westonb/open-pmic-pcb/testing/eff_test1.csv

Vin | Iin | Pin | Vout | Iout | Pout
3.3000000000000003 | 0.0032875000000000005 | 0.010848750000000002 | 1.7969175000000002 | 0.0 | 0.0
3.3000000000000003 | 0.008387499999999999 | 0.02767875 | 1.796665 | 0.00959778 | 0.0172439954037
3.3001250000000004 | 0.013874999999999998 | 0.045789234375 | 1.7965787500000001 | 0.0195675125 | 0.03515457714785938
3.3000000000000003 | 0.01945 | 0.064185 | 1.7963137500000002 | 0.02970505 | 0.053359589759437505
3.3000000000000003 | 0.02495 | 0.082335 | 1.79613 | 0.0395469375 | 0.07103144085187499
3.3000000000000003 | 0.0307625 | 0.10151625000000002 | 1.7960725 | 0.049707387500000005 | 0.08927807173559375
3.3000000000000003 | 0.036399999999999995 | 0.12011999999999999 | 1.7958449999999997 | 0.0596313 | 0.10708857194849998
3.3000000000000003 | 0.042074999999999994 | 0.13884749999999998 | 1.7958175 | 0.06977268750000001 | 0.12529901323453127
3.3000000000000003 | 0.047725 | 0.1574925 | 1.7956525 | 0.079599375 | 0.1429328167171875
3.3000000000000003 | 0.0534625 | 0.17642625000000003 | 1.795515 | 0.08966632499999999 | 0.16099723153237497
3.3000000000000003 | 0.05945 | 0.19618500000000003 | 1.79535 | 0.09971620000000002 | 0.17902547967000004
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
