westonb/open-pmic-pcb/testing/current_sense_50ma.PNG

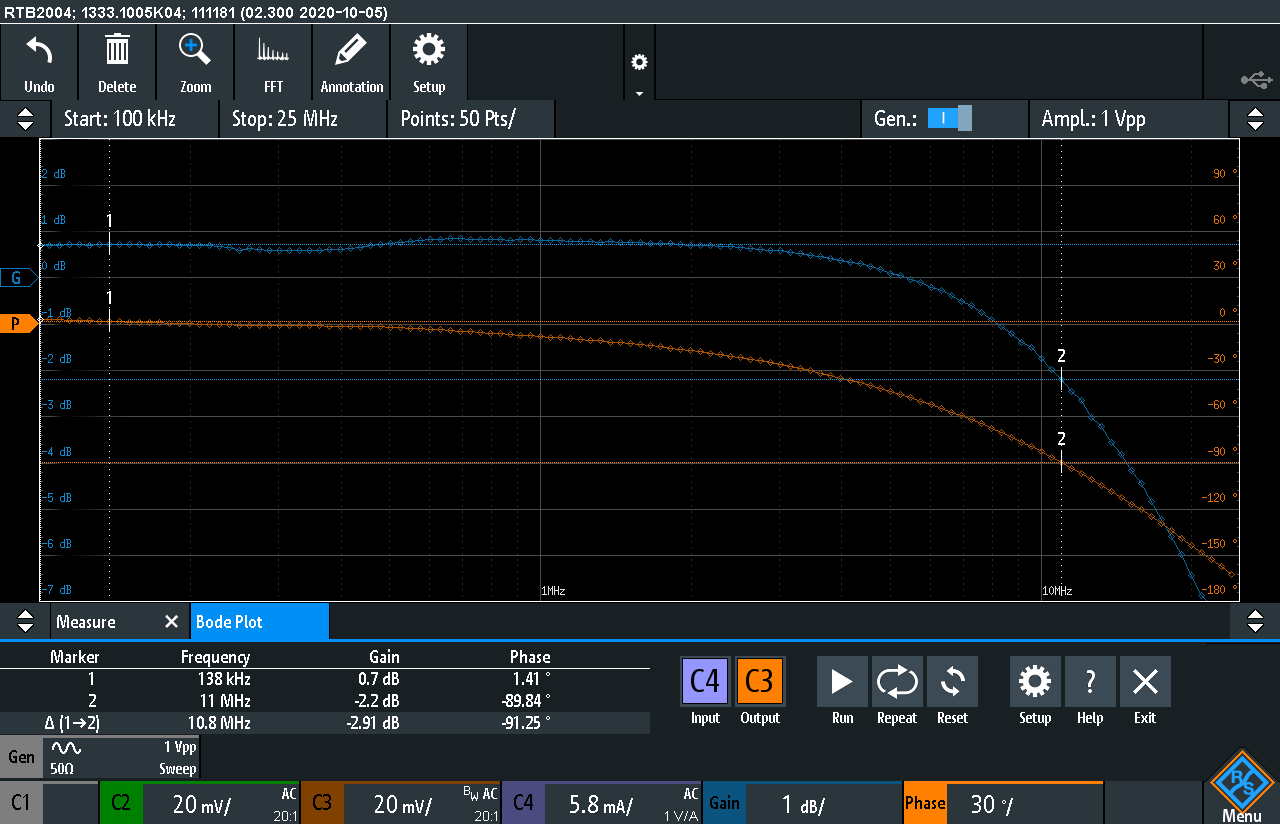
testing/current_sense_50ma.PNG
