westonb/open-pmic-pcb/testing/current_sense_200ma.PNG

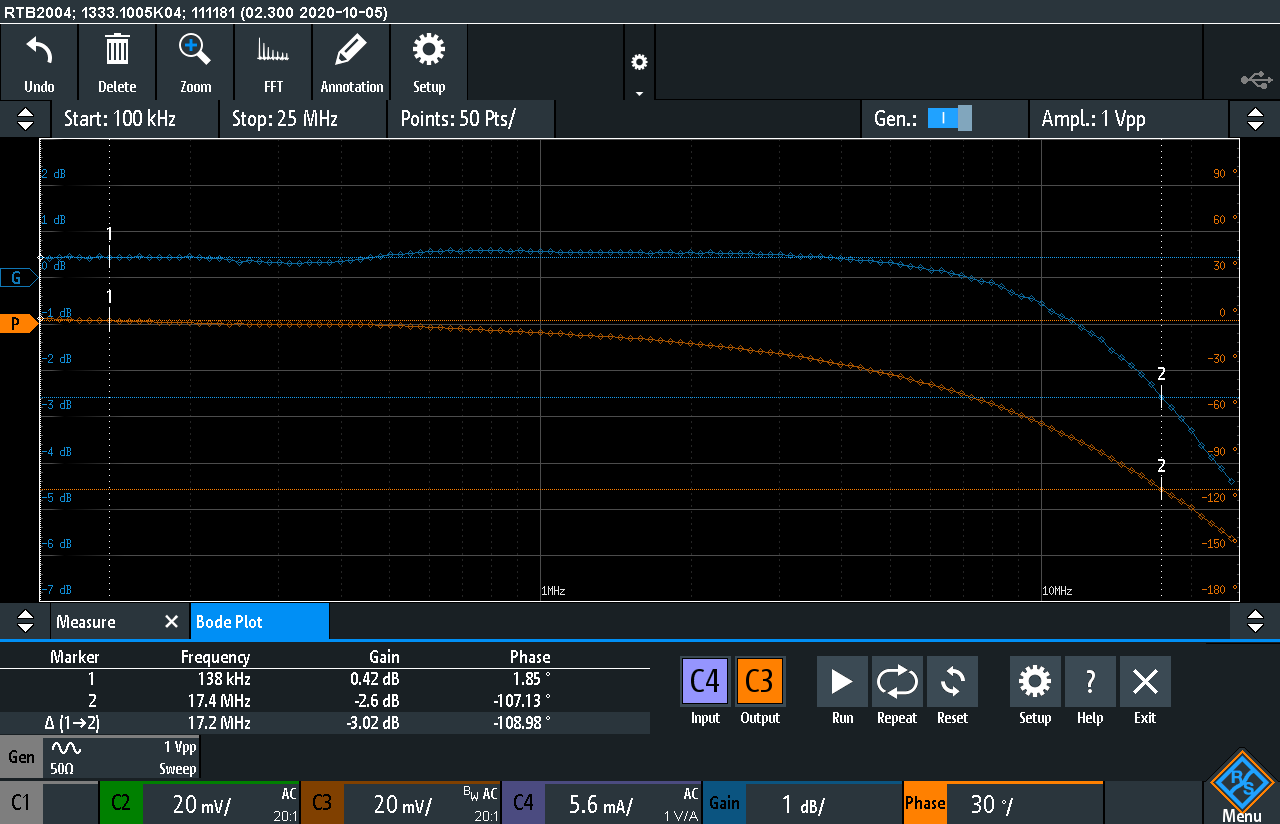
testing/current_sense_200ma.PNG
