westonb/open-pmic-pcb/testing/eff1.png

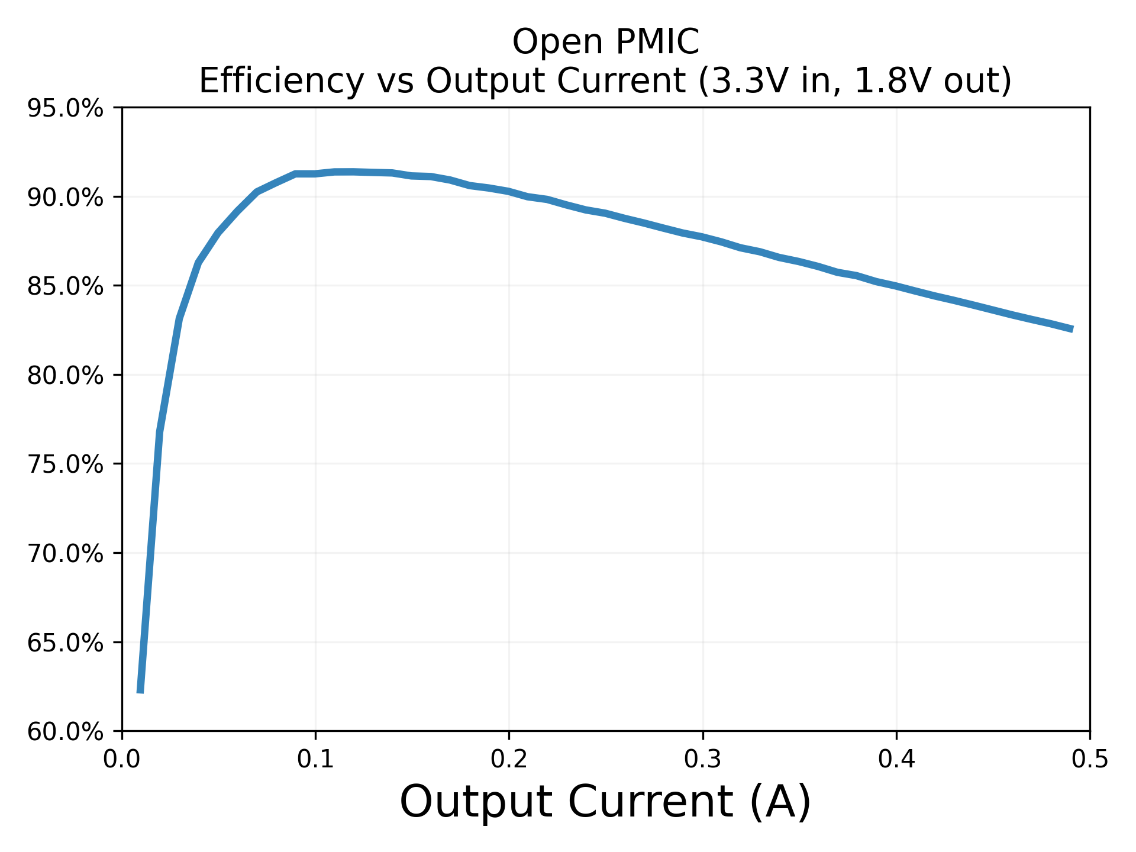
testing/eff1.png
