westonb/open-pmic-pcb/testing/loop_gain_6_ohm.PNG

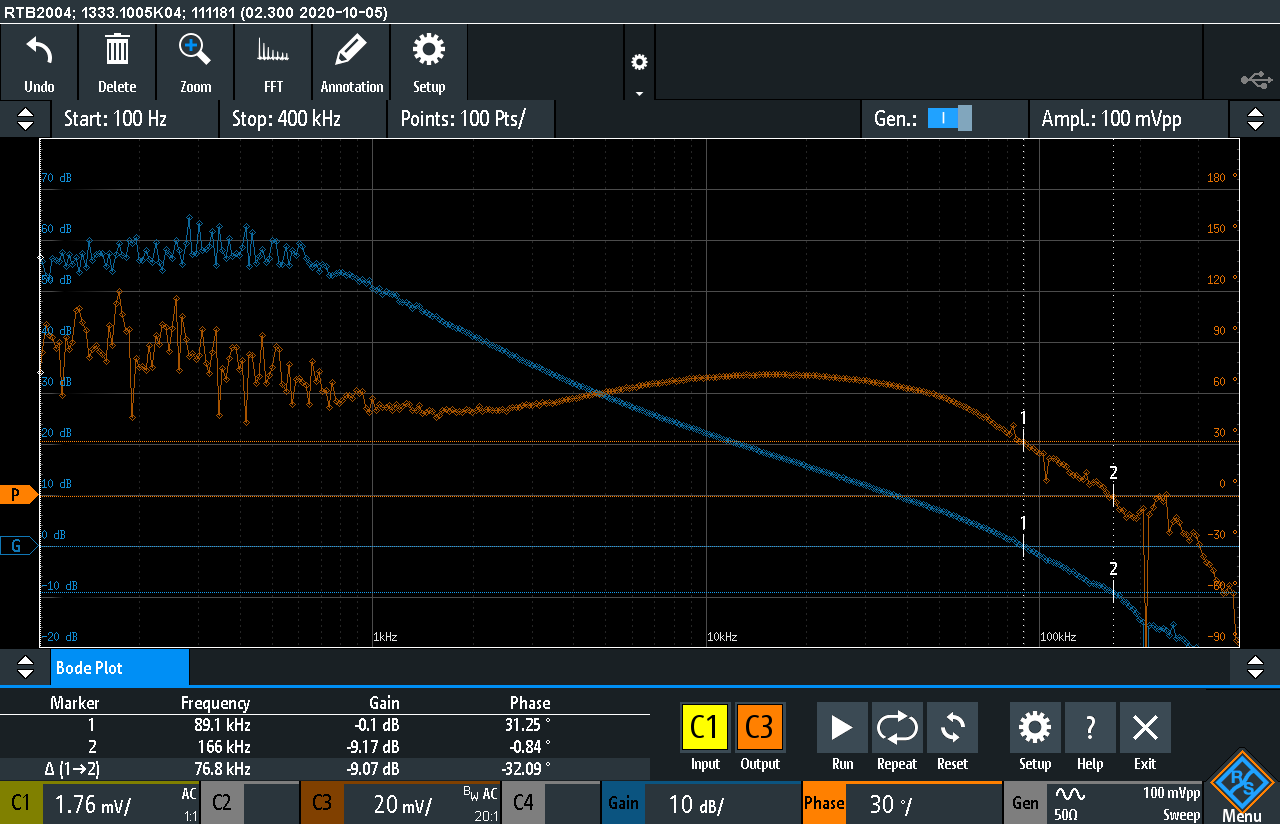
testing/loop_gain_6_ohm.PNG
