westonb/open-pmic-pcb/testing/loop_gain_12_ohm.PNG

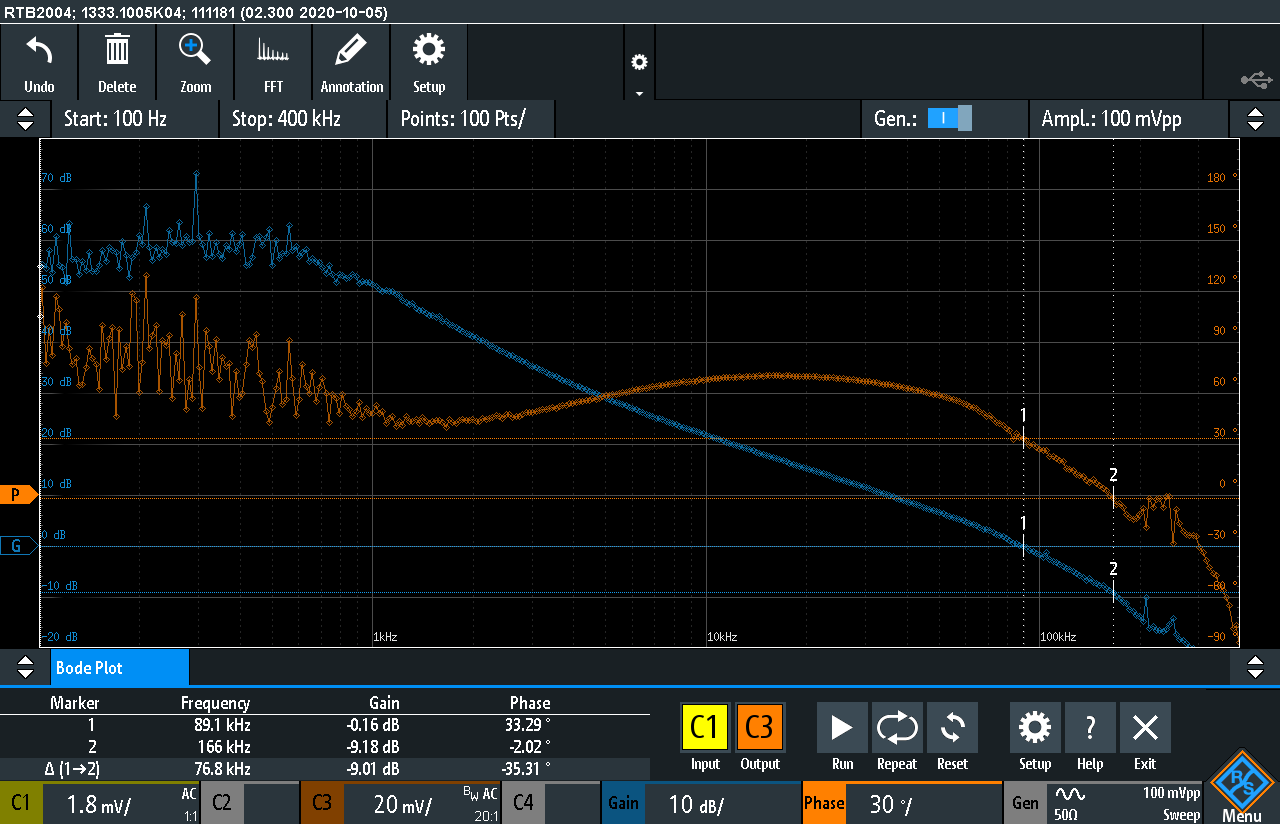
testing/loop_gain_12_ohm.PNG
