westonb/open-pmic-pcb/testing/loop_gain_open.PNG

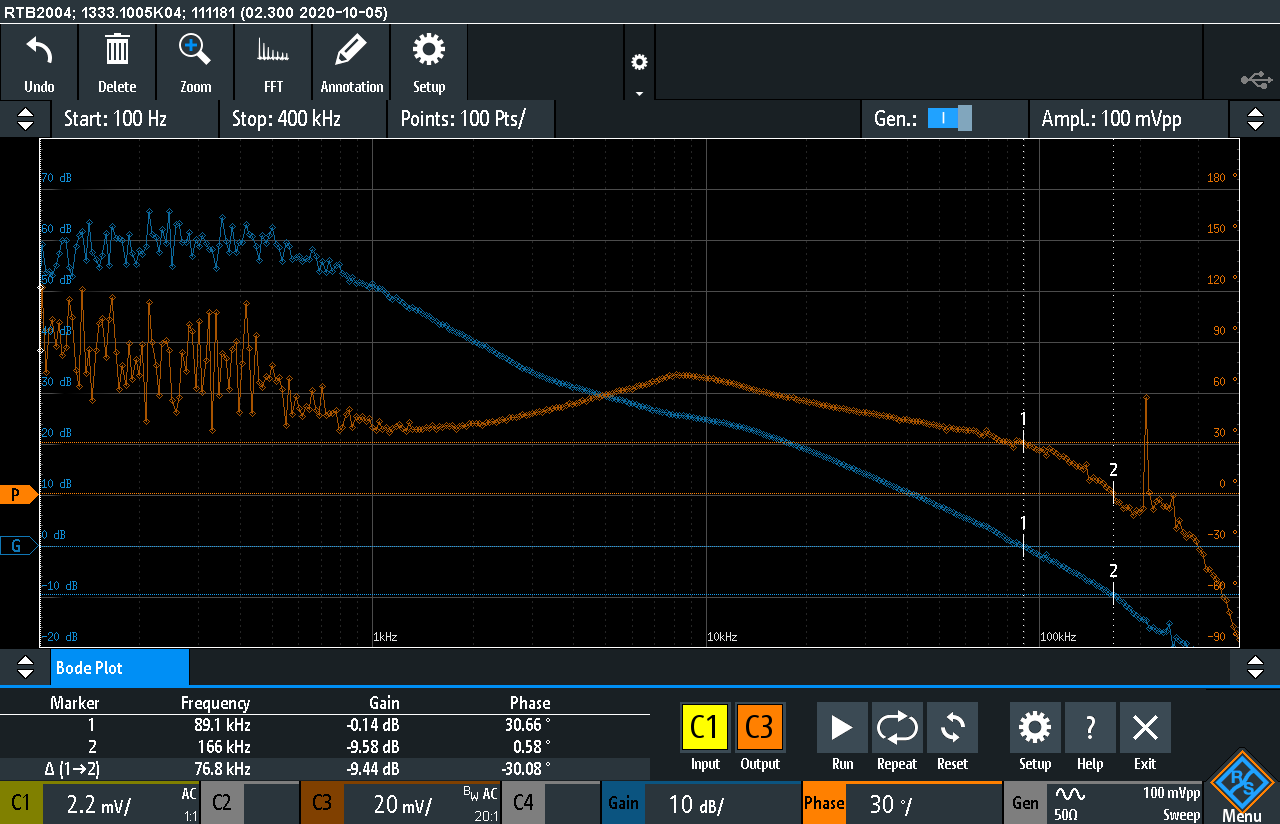
testing/loop_gain_open.PNG
