westonb/open-pmic-pcb/testing/OTA_180pF_Load.PNG

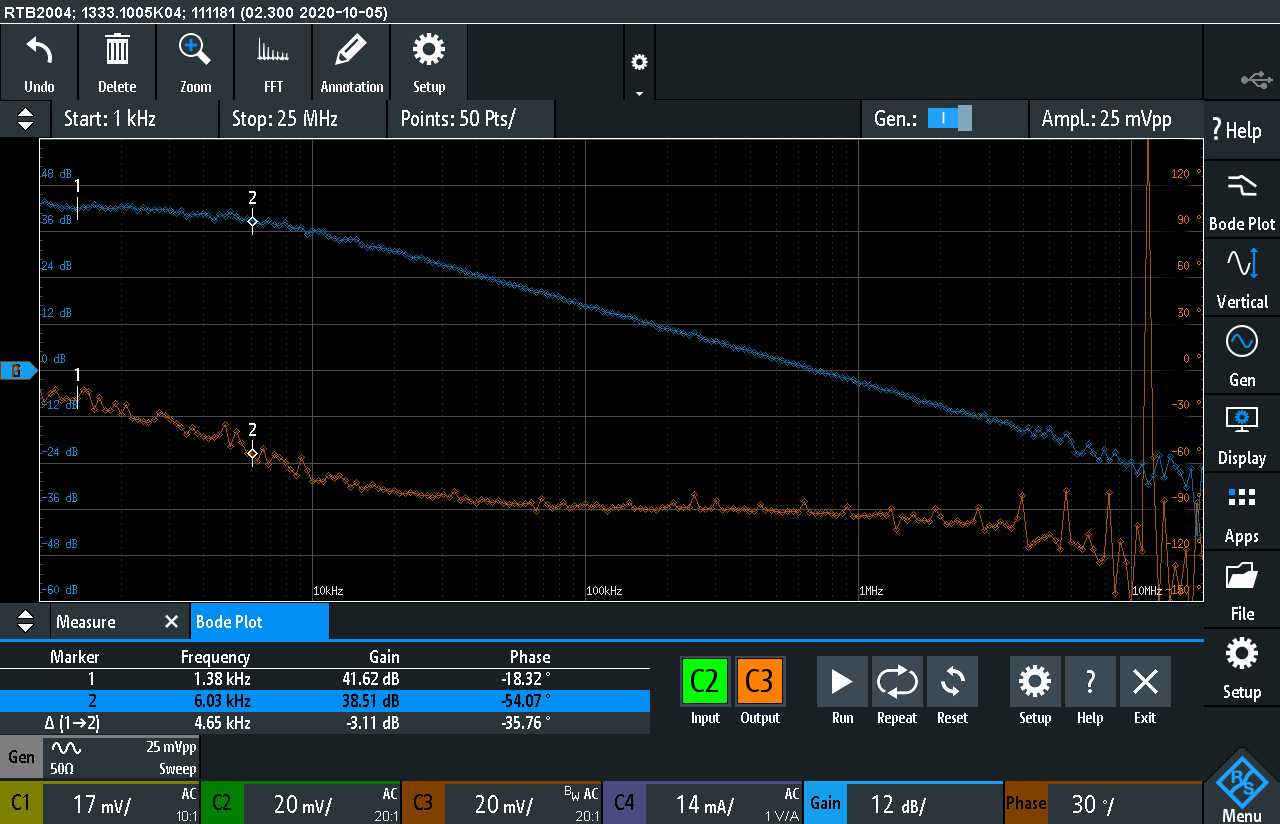
testing/OTA_180pF_Load.PNG
