westonb/open-pmic-pcb/testing/OTA_no_load.PNG

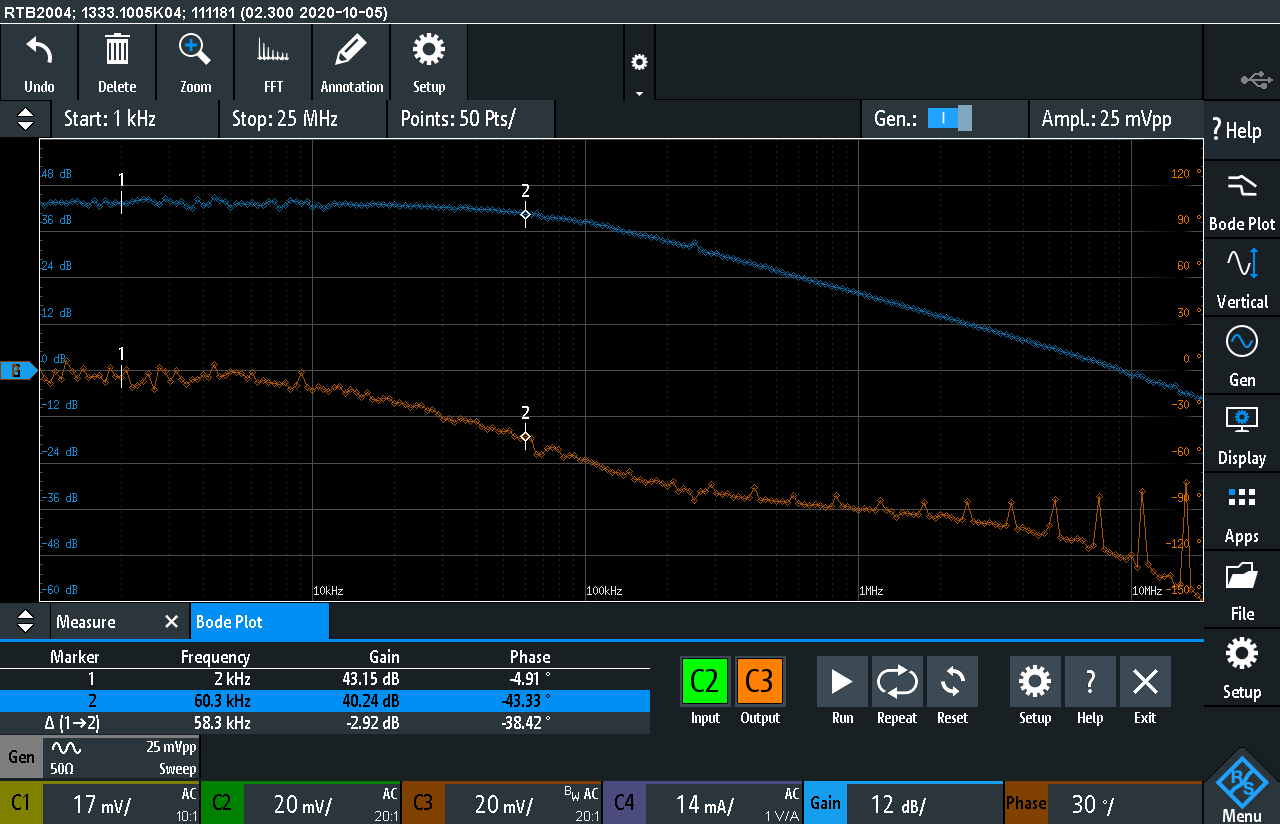
testing/OTA_no_load.PNG
