westonb/open-pmic-pcb/testing/transient.PNG

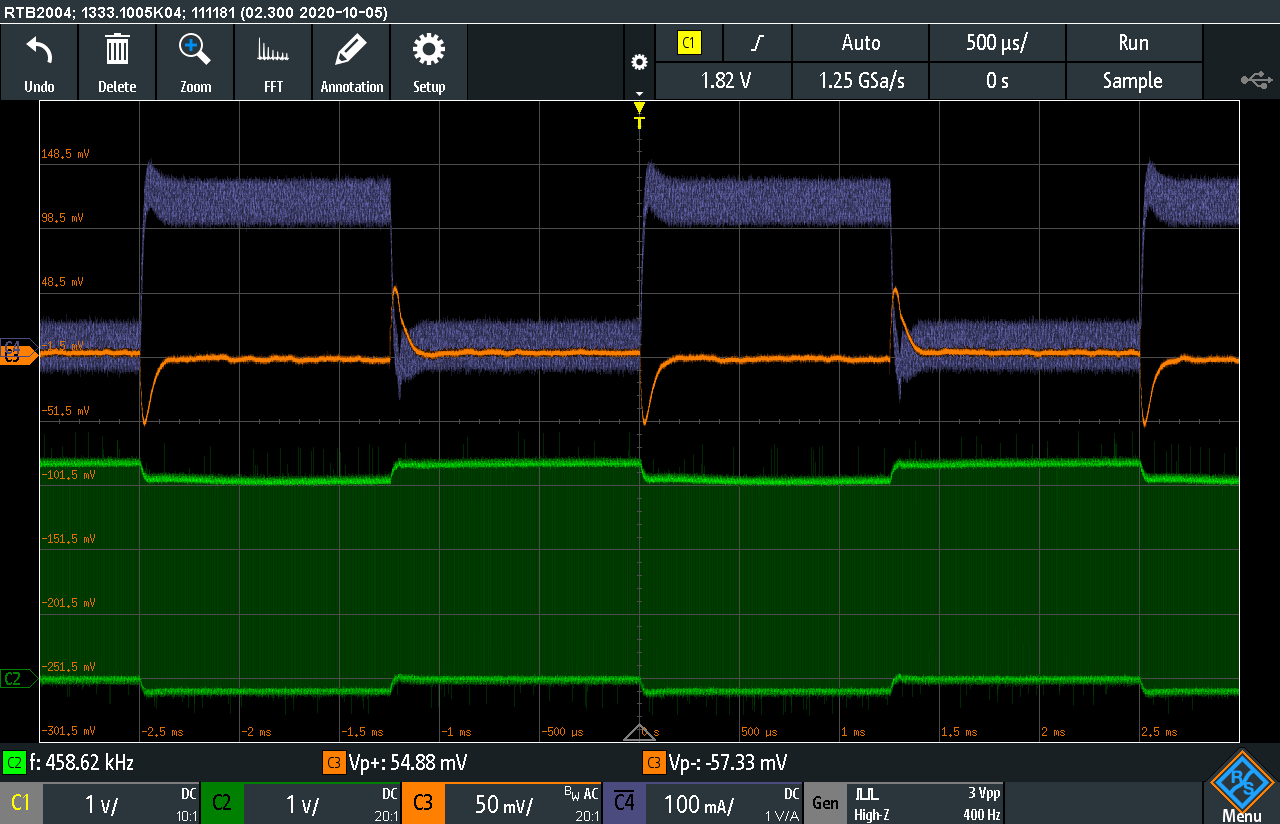
testing/transient.PNG
