westonb/open-pmic-pcb/pmic-test-board/pmic-test-board.pdf

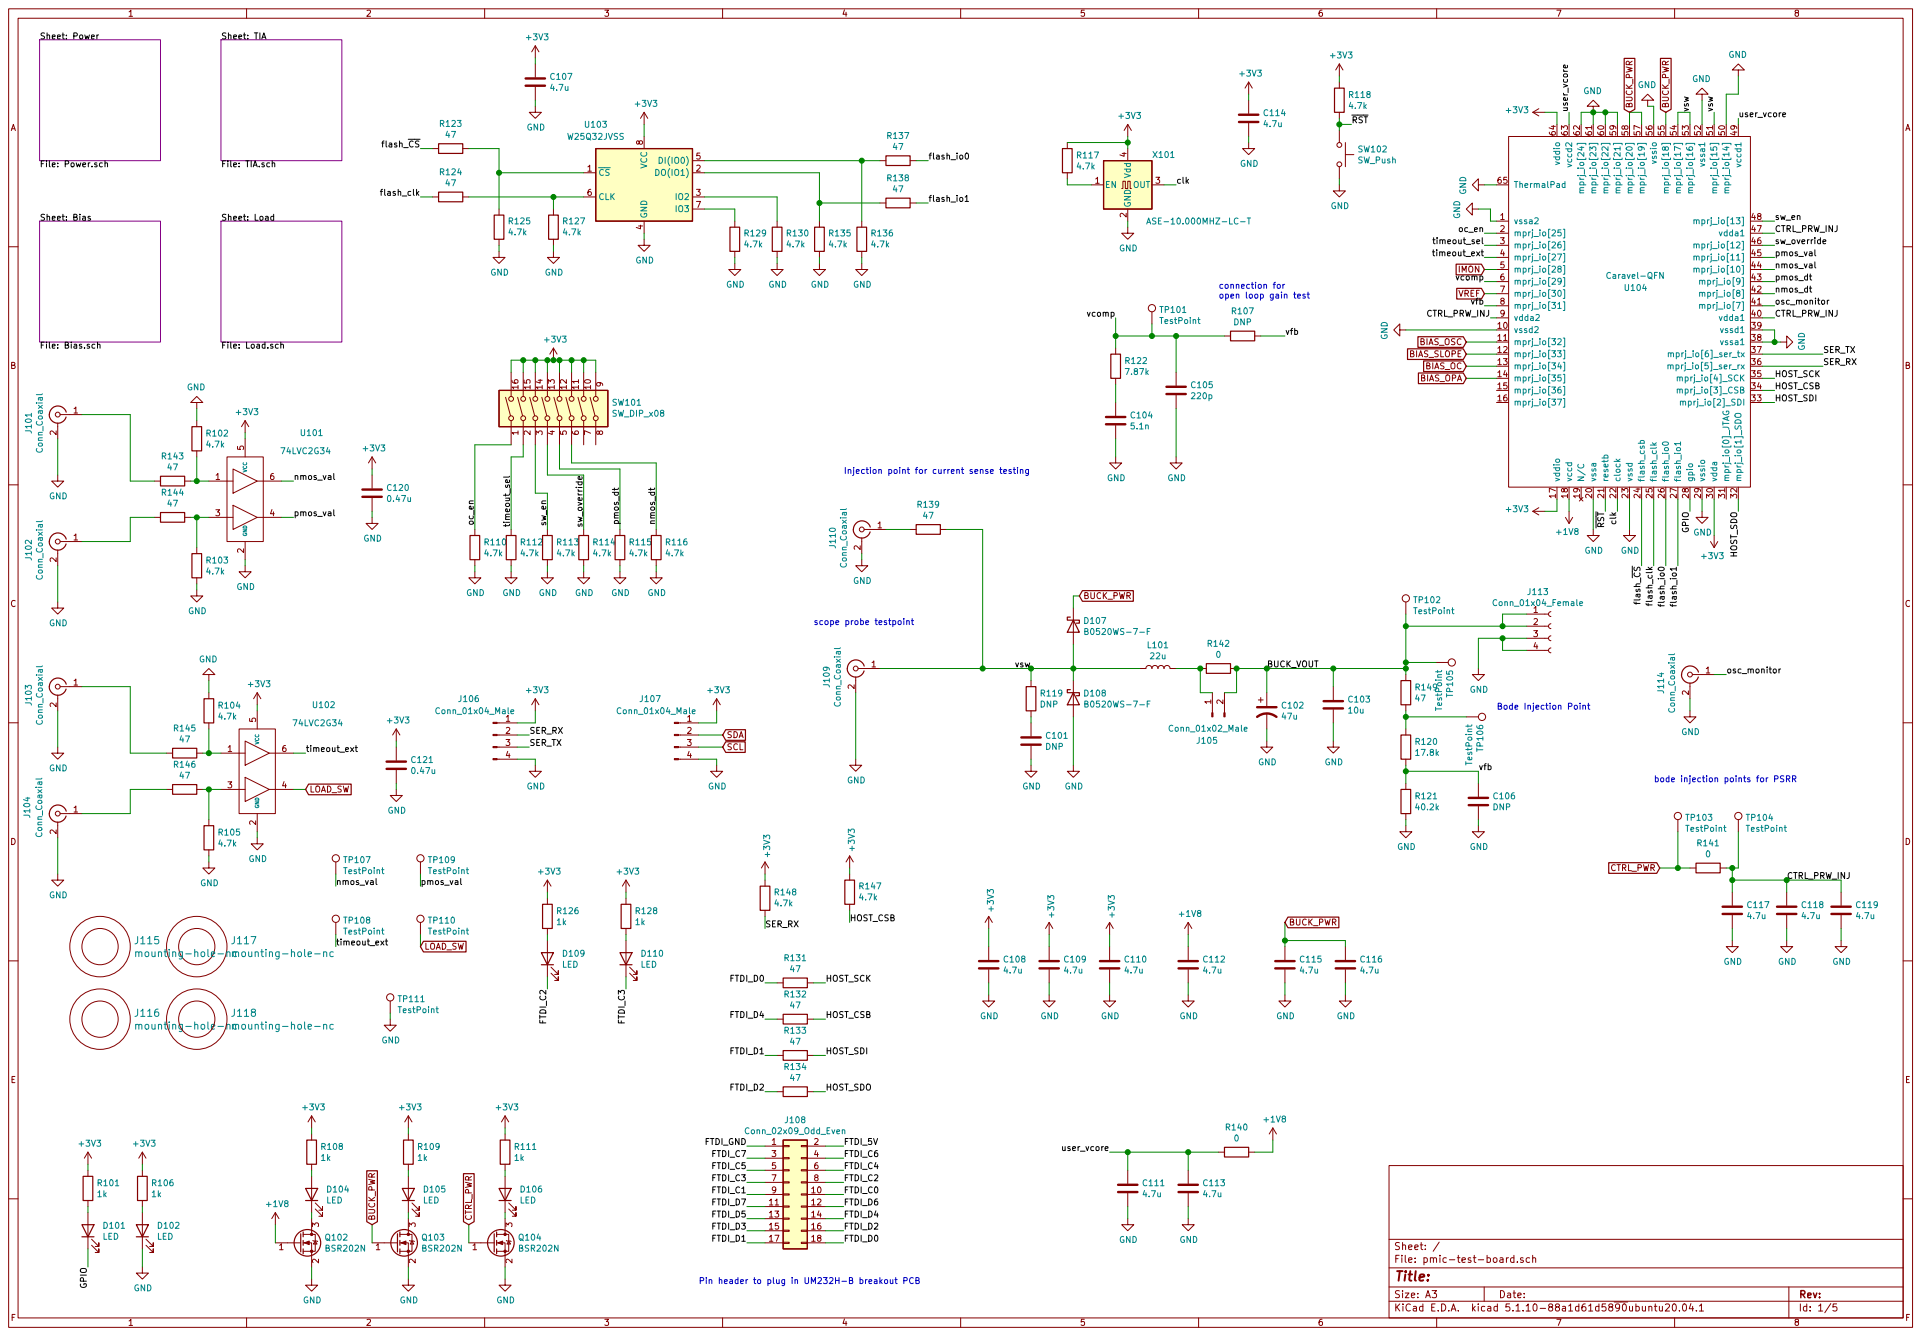
[picture p10: page 1]

File: TIA.sch Sheet: Power File: Power.sch

osc_monitor connection for open loop gain test

Injection point for current sense testing

bode injection points for PSRR

File: pmic-test-board.sch Sheet: /

Pin header to plug in UM232H-B breakout PCB

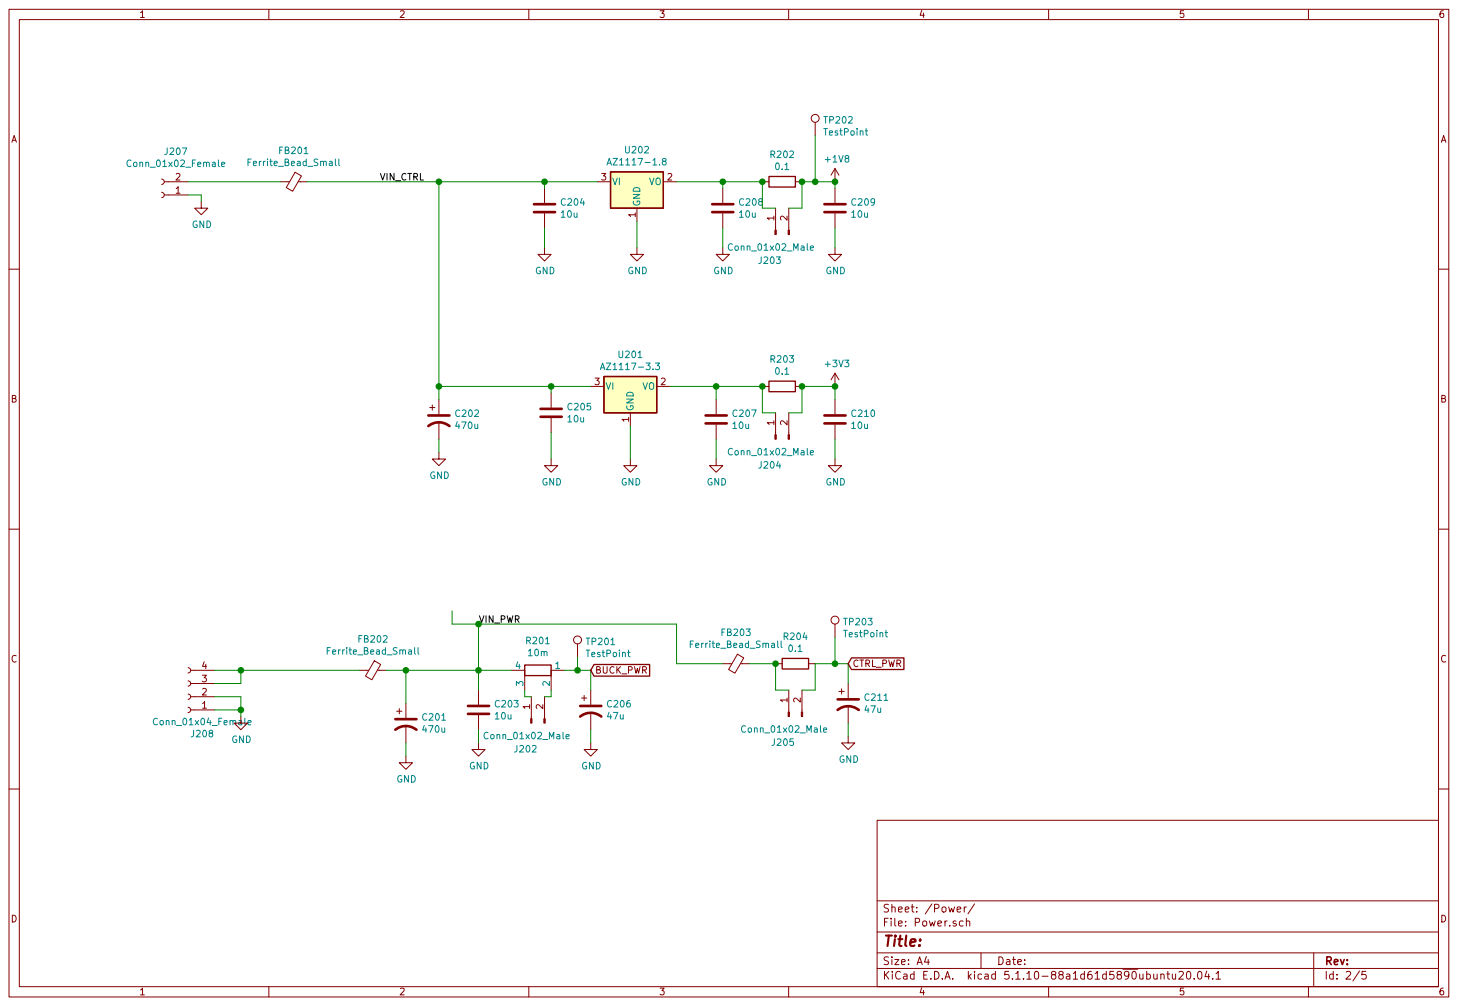
[picture p11: page 2]

1 VO 2 VI 3 U202 AZ1117-1.8 GND GND

Id: 2/5 Title: File: Power.sch Sheet: /Power/ C206

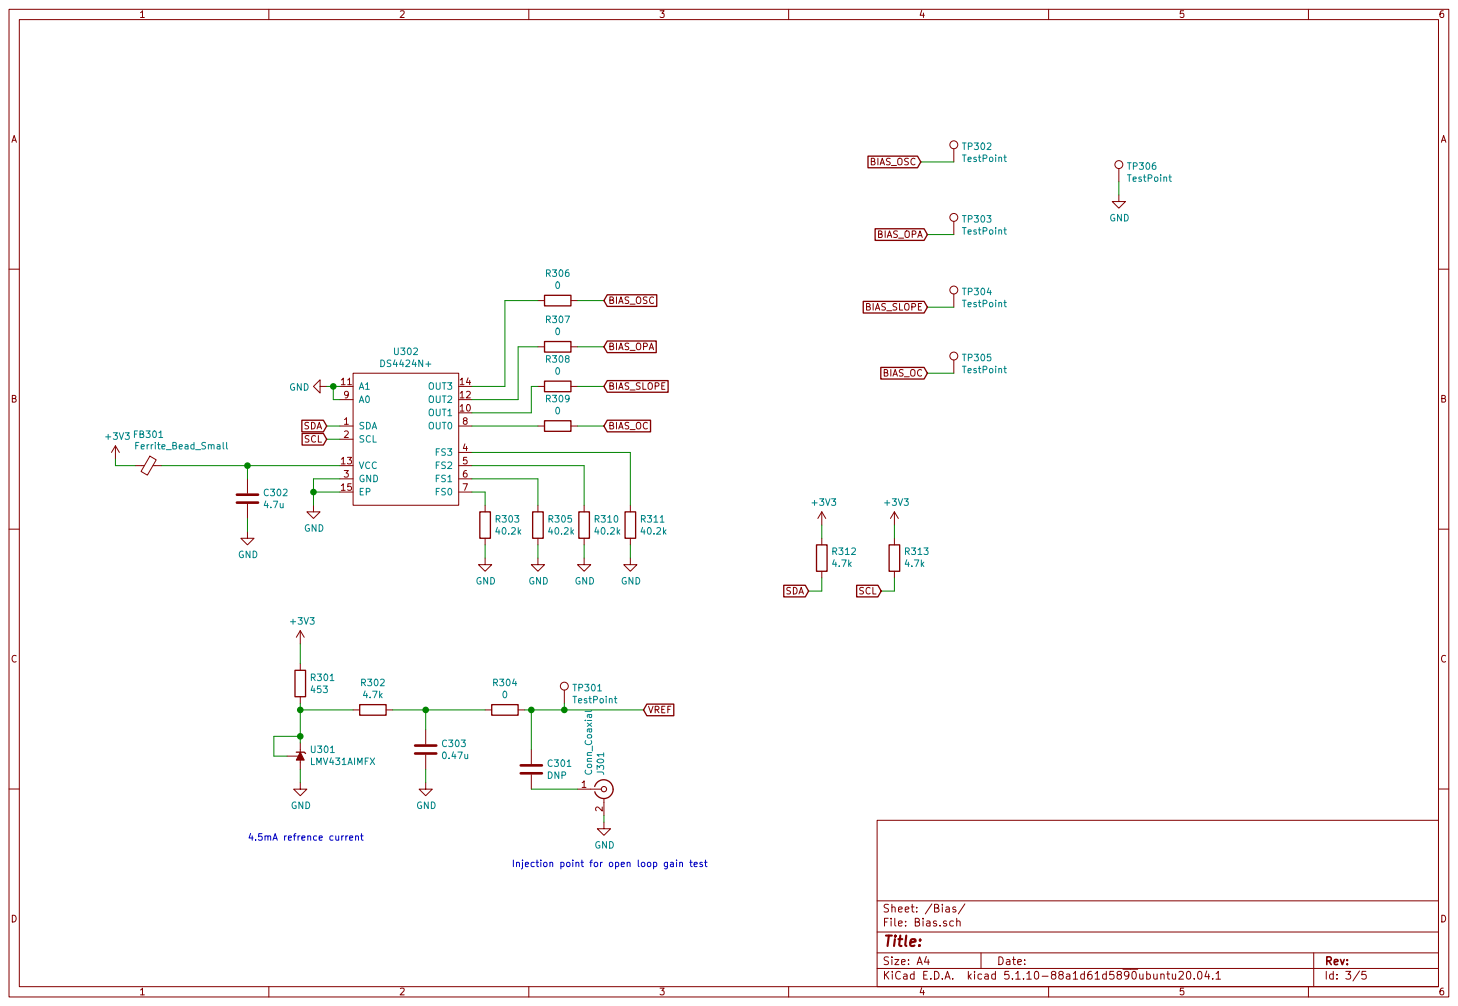
[picture p12: page 3]

Id: 3/5 Title: File: Bias.sch Sheet: /Bias/ R301

Injection point for open loop gain test

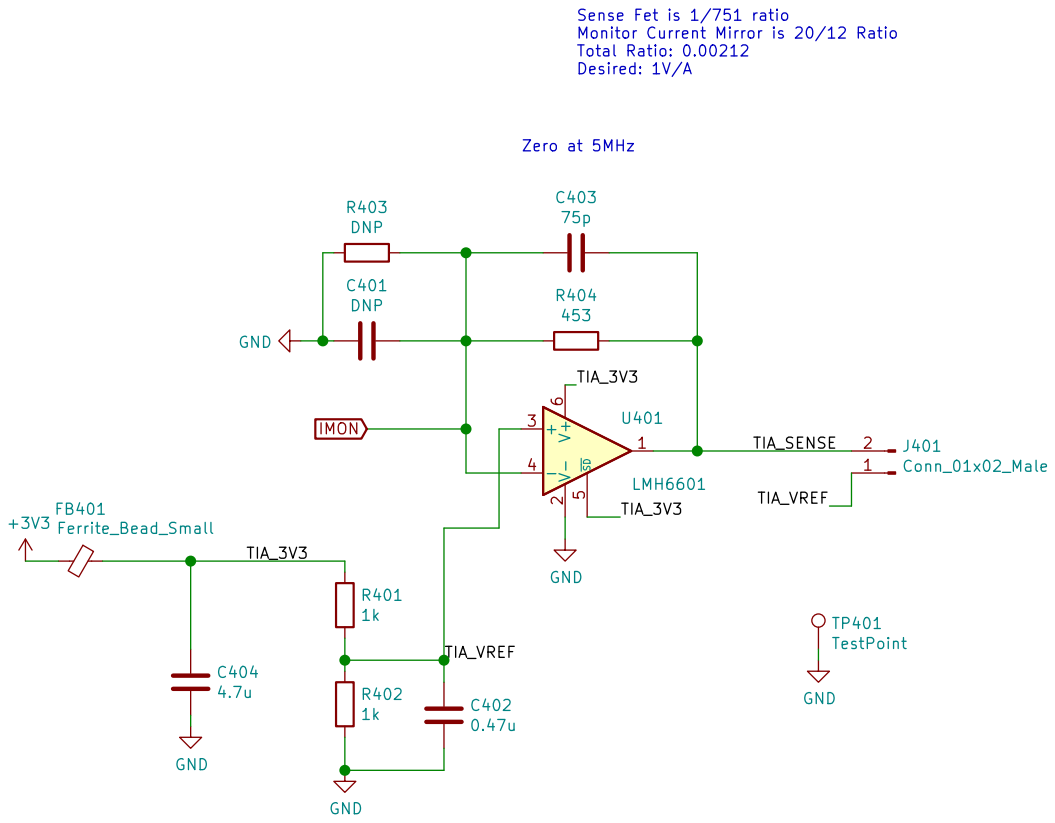
[picture p13: page 4]

TIA_VREF Sense Fet is 1/751 ratio Monitor Current Mirror is 20/12 Ratio Total Ratio: 0.00212 Desired: 1V/A

Id: 4/5 Title: File: TIA.sch Sheet: /TIA/

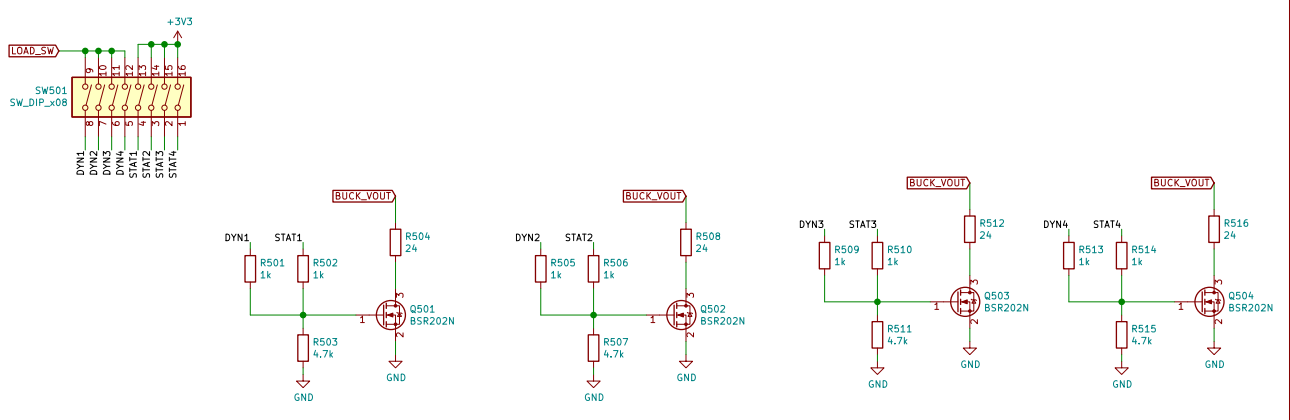
[picture p14: page 5]
