westonb/open-pmic-pcb/pmic-test-board/pmic-test-board.kicad_pcb

## KiCad design pmic-test-board/pmic-test-board.kicad_pcb (2021-12-18)

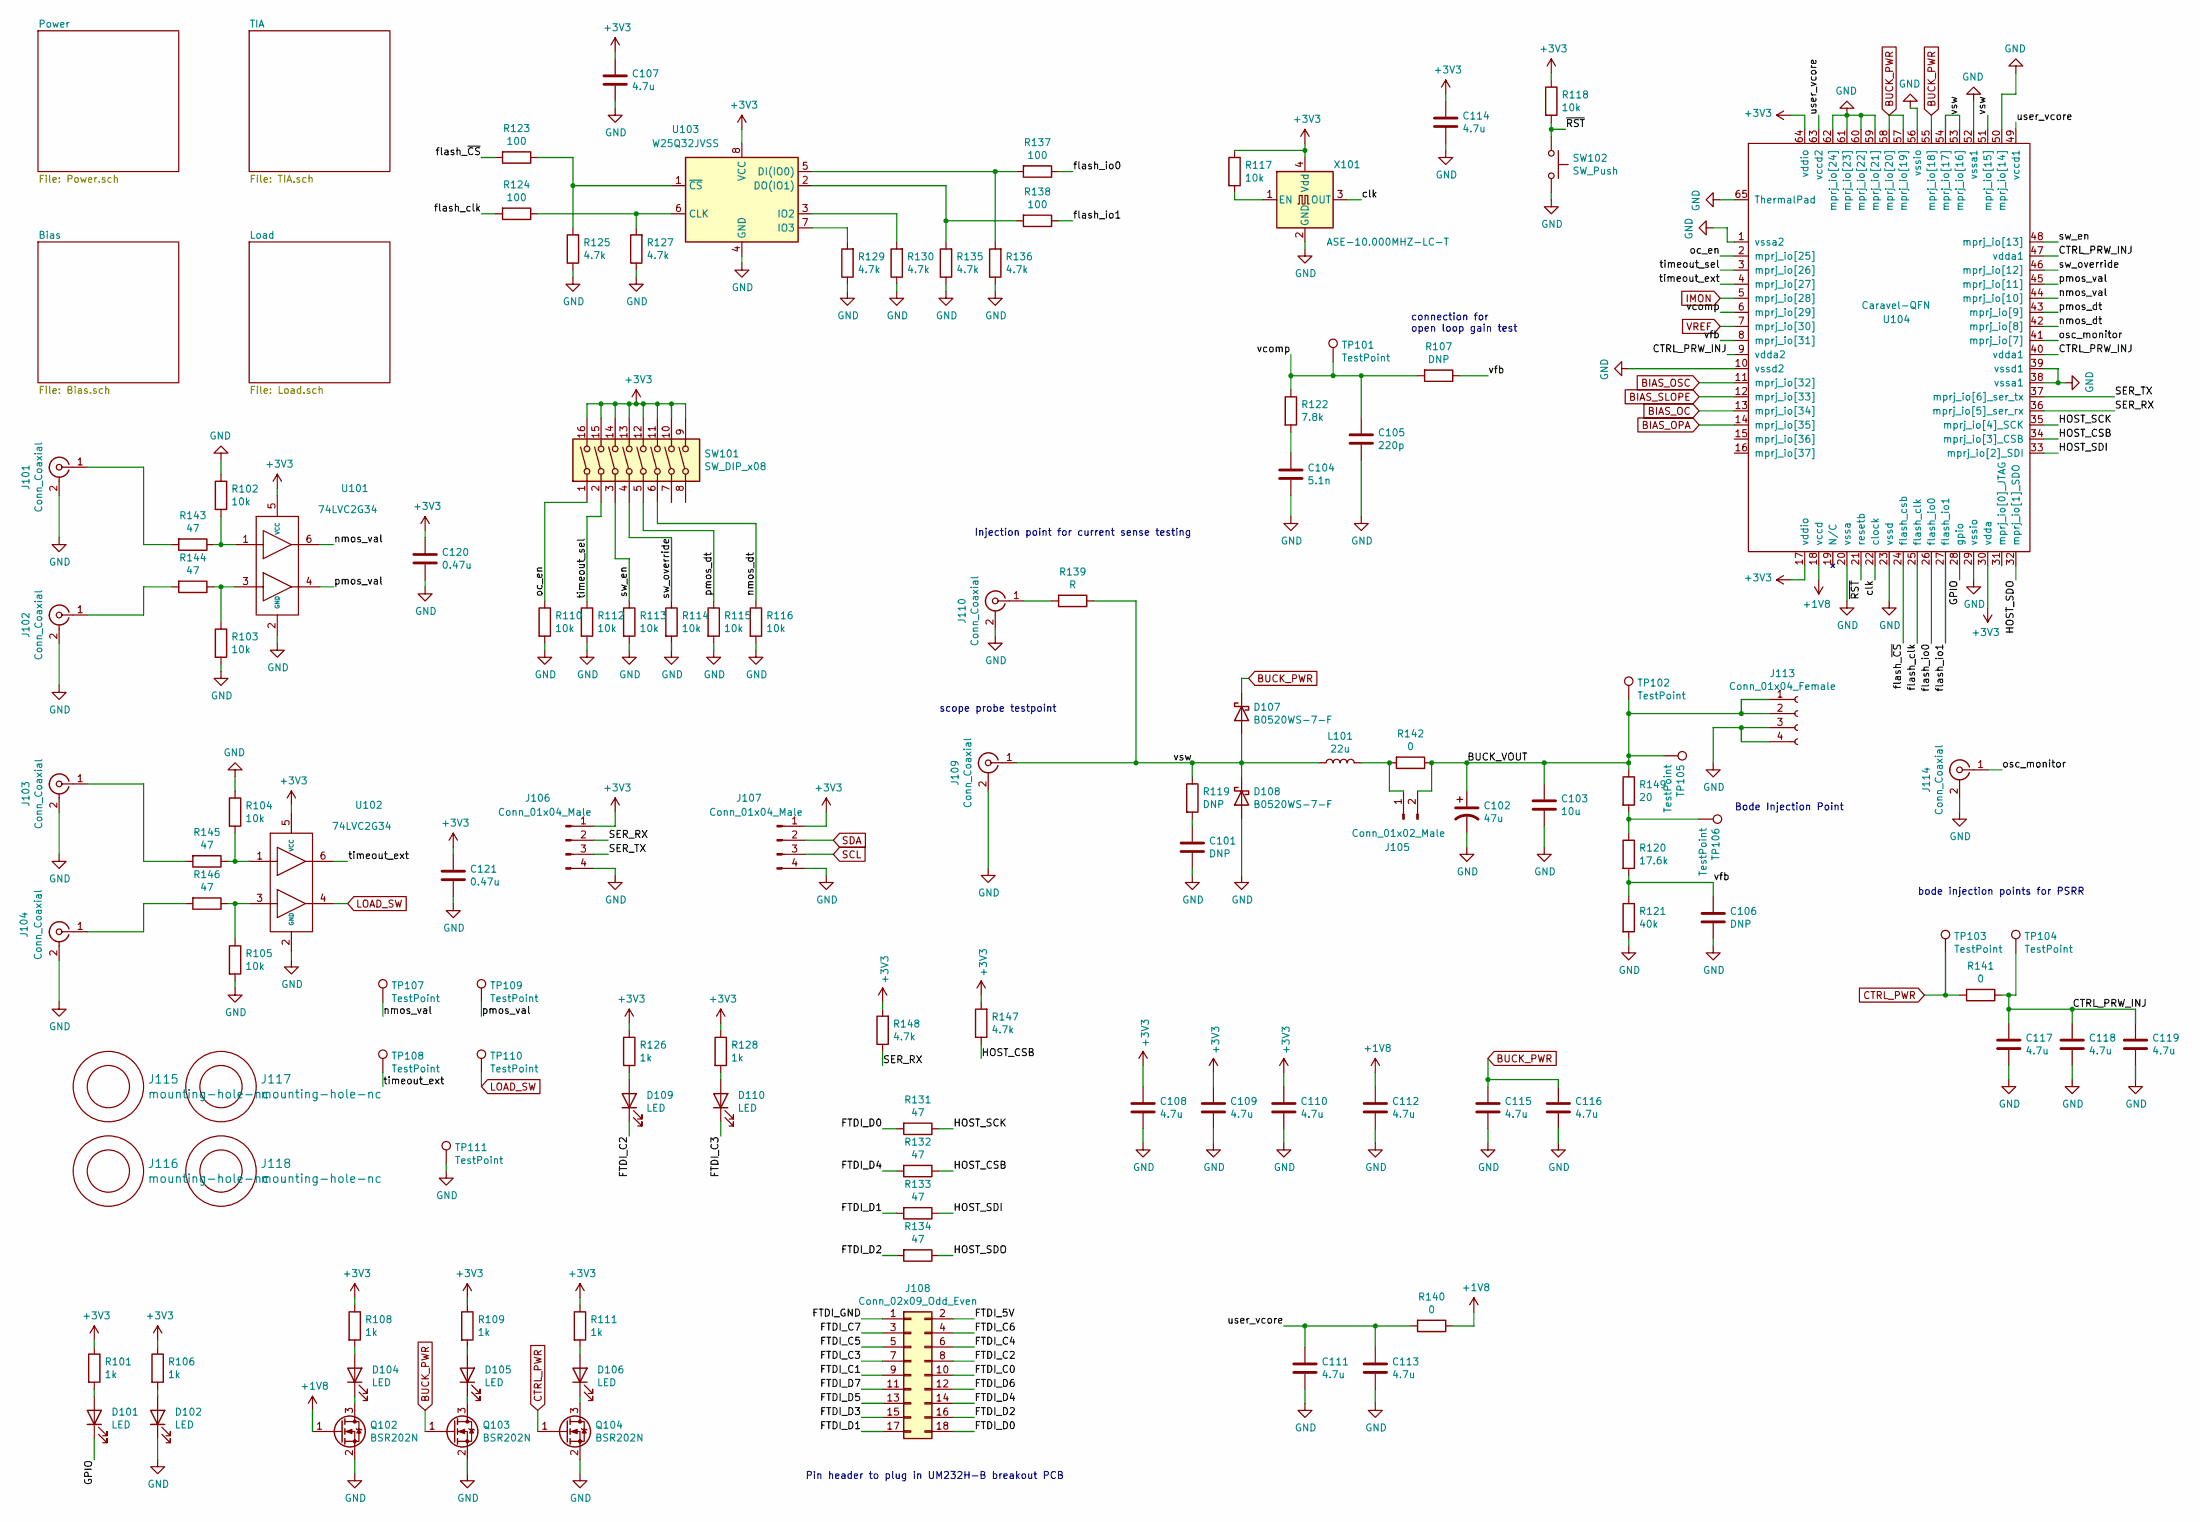
[picture p15: schematic pmic-test-board.sch]

Parts:
C101, C106: DNP; C_0603_1608Metric
C102: 47u; CP_EIA-3528-12_Kemet-T; MPN T520B476M008ATE035
C103: 10u; C_0805_2012Metric
C104: 5.1n; C_0603_1608Metric
C105: 220p; C_0603_1608Metric
C107, C108, C109, C110, C111, C112, C113, C114, C115, C116, C117, C118, C119: 4.7u; C_0603_1608Metric
C120, C121: 0.47u; C_0603_1608Metric
D101, D102, D104, D105, D106, D109, D110: LED; LED_0603_1608Metric_Castellated; MPN 150060RS75000
D107, D108: B0520WS-7-F; D_SOD-323; MPN B0520WS-7-F
J101, J102, J103: Conn_Coaxial; CONN_SMA_EDGE_SAMTEC_SMA_J_P_H_ST_EM1
J104: Conn_Coaxial; CONN_SMA_EDGE_SAMTEC_SMA_J_P_H_ST_EM1; MPN SMA-J-P-H-ST-EM1
J105: Conn_01x02_Male; PinHeader_1x02_P2.54mm_Vertical
J106, J107: Conn_01x04_Male; PinHeader_1x04_P2.54mm_Vertical
J108: Conn_02x09_Odd_Even; PinHeader_2x09_P2.54mm_Vertical
J109, J114: Conn_Coaxial; PK007-015
J110: Conn_Coaxial; SMA_Amphenol_132134_Vertical; MPN 132134
J113: Conn_01x04_Female; Terminal-block-plug_4x1_3.5mm-pitch; MPN 0395021004
J115, J116, J117, J118: mounting-hole-nc; M3-mounting-hole-insulated
L101: 22u; L_Wuerth_WE-PD-Typ-7345; MPN 7447779122
Q102, Q103, Q104: BSR202N; SOT-23; MPN BSR202NL6327HTSA1
R101, R106, R108, R109, R111, R126, R128: 1k; R_0603_1608Metric
R102, R103, R104, R105, R110, R112, R113, R114, R115, R116, R117, R118: 10k; R_0603_1608Metric
R107, R119: DNP; R_0603_1608Metric
R120: 17.6k; R_0603_1608Metric
R121: 40k; R_0603_1608Metric
R122: 7.8k; R_0603_1608Metric
R123, R124, R137, R138: 100; R_0603_1608Metric
R125, R127, R129, R130, R135, R136, R147, R148: 4.7k; R_0603_1608Metric
R131, R132, R133, R134, R143, R144, R145, R146: 47; R_0603_1608Metric
R139: R; R_1206_3216Metric
R140, R141, R142: 0; R_0603_1608Metric
R149: 20; R_0603_1608Metric
SW101: SW_DIP_x08; SW_DIP_SPSTx08_Slide_6.7x21.88mm_W7.62mm_P2.54mm_LowProfile; MPN DS01C-254-S-08BE
SW102: SW_Push; SW_SPST_PTS810; MPN PTS810 SJK 250 SMTR LFS
TP101, TP102, TP103, TP104, TP105, TP106, TP107, TP108, TP109, TP110, TP111: TestPoint; THM_COMPACT
U101, U102: 74LVC2G34; SOT-363_SC-70-6
U103: W25Q32JVSS; SOIC-8_5.23x5.23mm_P1.27mm; MPN W25Q32JVSSIQ
U104: Caravel-QFN; QFN-64-1EP_9x9mm_P0.5mm_EP6x6mm
X101: ASE-10.000MHZ-LC-T; Oscillator_SMD_Abracon_ASE-4Pin_3.2x2.5mm; MPN ASE-10.000MHZ-LC-T

Connections:
+1V8: C112.1, Q102.1 (G), R140.1, U104.18 (vccd); also elsewhere on the board
+3V3: C107.1, C108.1, C109.1, C110.1, C114.1, C120.1, C121.1, J106.1, J107.1, R101.1, R106.1, R108.1, R109.1, R111.1, R117.1, R118.1, R126.1, R128.1, R147.2, R148.2, SW101.9, SW101.10, SW101.11, SW101.12, SW101.13, SW101.14, SW101.15, SW101.16, U101.5 (VCC), U102.5 (VCC), U103.8 (VCC), U104.17 (vddio), U104.30 (vdda), U104.64 (vddio), X101.4 (Vdd); also elsewhere on the board
/BUCK_VOUT: C102.1, C103.1, J105.2, J113.1, J113.2, R142.1, R149.1, TP102.1, TP105.1
/CTRL_PRW_INJ: C117.1, C118.1, C119.1, R141.1, TP104.1, U104.9 (vdda2), U104.40 (vdda1), U104.47 (vdda1)
/FTDI_5V: J108.2
/FTDI_C0: J108.10
/FTDI_C1: J108.9
/FTDI_C2: D109.1 (K), J108.8
/FTDI_C3: D110.1 (K), J108.7
/FTDI_C4: J108.6
/FTDI_C5: J108.5
/FTDI_C6: J108.4
/FTDI_C7: J108.3
/FTDI_D0: J108.18, R131.2
/FTDI_D1: J108.17, R133.2
/FTDI_D2: J108.16, R134.2
/FTDI_D3: J108.15
/FTDI_D4: J108.14, R132.2
/FTDI_D5: J108.13
/FTDI_D6: J108.12
/FTDI_D7: J108.11
/FTDI_GND: J108.1
/GPIO: D101.1 (K), U104.28 (gpio)
/HOST_CSB: R132.1, R147.1, U104.34 (mprj_io[3]_CSB)
/HOST_SCK: R131.1, U104.35 (mprj_io[4]_SCK)
/HOST_SDI: R133.1, U104.33 (mprj_io[2]_SDI)
/HOST_SDO: R134.1, U104.32 (mprj_io[1]_SDO)
/SER_RX: J106.2, R148.1, U104.36 (mprj_io[5]_ser_rx)
/SER_TX: J106.3, U104.37 (mprj_io[6]_ser_tx)
/clk: U104.22 (clock), X101.3 (OUT)
/flash_clk: R124.2, U104.25 (flash_clk)
/flash_io0: R137.1, U104.26 (flash_io0)
/flash_io1: R138.1, U104.27 (flash_io1)
/flash_~CS: R123.2, U104.24 (flash_csb)
/nmos_dt: R116.1, SW101.6, U104.42 (mprj_io[8])
/nmos_val: TP107.1, U101.6, U104.44 (mprj_io[10])
/oc_en: R110.1, SW101.1, U104.2 (mprj_io[25])
/osc_monitor: J114.1 (In), U104.41 (mprj_io[7])
/pmos_dt: R115.1, SW101.5, U104.43 (mprj_io[9])
/pmos_val: TP109.1, U101.4, U104.45 (mprj_io[11])
/sw_en: R113.1, SW101.3, U104.48 (mprj_io[13])
/sw_override: R114.1, SW101.4, U104.46 (mprj_io[12])
/timeout_ext: TP108.1, U102.6, U104.4 (mprj_io[27])
/timeout_sel: R112.1, SW101.2, U104.3 (mprj_io[26])
/user_vcore: C111.1, C113.1, R140.2, U104.49 (vccd1), U104.63 (vccd2)
/vcomp: C105.1, R107.2, R122.1, TP101.1, U104.6 (mprj_io[29])
/vfb: C106.1, R107.1, R120.2, R121.1, U104.8 (mprj_io[31])
/vsw: D107.2 (A), D108.1 (K), J109.1 (In), L101.1, R119.1, R139.1, U104.51 (mprj_io[15]), U104.53 (mprj_io[16]), U104.54 (mprj_io[17])
/~RST: R118.2, SW102.1, U104.21 (resetb)
BIAS_OC: U104.13 (mprj_io[34]); also elsewhere on the board
BIAS_OPA: U104.14 (mprj_io[35]); also elsewhere on the board
BIAS_OSC: U104.11 (mprj_io[32]); also elsewhere on the board
BIAS_SLOPE: U104.12 (mprj_io[33]); also elsewhere on the board
BUCK_PWR: C115.1, C116.1, D107.1 (K), Q103.1 (G), U104.55 (mprj_io[18]), U104.57 (mprj_io[19]), U104.58 (mprj_io[20]); also elsewhere on the board
CTRL_PWR: Q104.1 (G), R141.2, TP103.1; also elsewhere on the board
GND: C101.2, C102.2, C103.2, C104.2, C105.2, C106.2, C107.2, C108.2, C109.2, C110.2, C111.2, C112.2, C113.2, C114.2, C115.2, C116.2, C117.2, C118.2, C119.2, C120.2, C121.2, D102.1 (K), D108.2 (A), J101.2 (Ext), J102.2 (Ext), J103.2 (Ext), J104.2 (Ext), J106.4, J107.4, J109.2 (Ext), J110.2 (Ext), J113.3, J113.4, J114.2 (Ext), Q102.2 (S), Q103.2 (S), Q104.2 (S), R102.1, R103.2, R104.1, R105.2, R110.2, R112.2, R113.2, R114.2, R115.2, R116.2, R121.2, R125.1, R127.1, R129.1, R130.1, R135.1, R136.1, SW102.2, TP111.1, U101.2 (GND), U102.2 (GND), U103.4 (GND), U104.1 (vssa2), U104.10 (vssd2), U104.20 (vssa), U104.23 (vssd), U104.29 (vssio), U104.38 (vssa1), U104.39 (vssd1), U104.50 (mprj_io[14]), U104.52 (vssa1), U104.56 (vssio), U104.59 (mprj_io[21]), U104.60 (mprj_io[22]), U104.61 (mprj_io[23]), U104.62 (mprj_io[24]), U104.65 (ThermalPad), X101.2 (GND); also elsewhere on the board
IMON: U104.5 (mprj_io[28]); also elsewhere on the board
LOAD_SW: TP110.1, U102.4; also elsewhere on the board
unnamed: C101.1, R119.2
unnamed: C104.1, R122.2
unnamed: D101.2 (A), R101.2
unnamed: D102.2 (A), R106.2
unnamed: D104.1 (K), Q102.3 (D)
unnamed: D104.2 (A), R108.2
unnamed: D105.1 (K), Q103.3 (D)
unnamed: D105.2 (A), R109.2
unnamed: D106.1 (K), Q104.3 (D)
unnamed: D106.2 (A), R111.2
unnamed: D109.2 (A), R126.2
unnamed: D110.2 (A), R128.2
unnamed: J101.1 (In), R143.2
unnamed: J102.1 (In), R144.2
unnamed: J103.1 (In), R145.2
unnamed: J104.1 (In), R146.2
unnamed: J105.1, L101.2, R142.2
unnamed: J110.1 (In), R139.2
unnamed: R102.2, R143.1, U101.1
unnamed: R103.1, R144.1, U101.3
unnamed: R104.2, R145.1, U102.1
unnamed: R105.1, R146.1, U102.3
unnamed: R117.2, X101.1 (EN)
unnamed: R120.1, R149.2, TP106.1
unnamed: R123.1, R125.2, U103.1 (~CS)
unnamed: R124.1, R127.2, U103.6 (CLK)
unnamed: R129.2, U103.7 (IO3)
unnamed: R130.2, U103.3 (IO2)
unnamed: R135.2, R138.2, U103.2 (DO(IO1))
unnamed: R136.2, R137.2, U103.5 (DI(IO0))
SCL: J107.3; also elsewhere on the board
SDA: J107.2; also elsewhere on the board
VREF: U104.7 (mprj_io[30]); also elsewhere on the board

Notes on the sheet:
Pin header to plug in UM232H-B breakout PCB
scope probe testpoint
Injection point for current sense testing
bode injection points for PSRR
connection for open loop gain test
Bode Injection Point

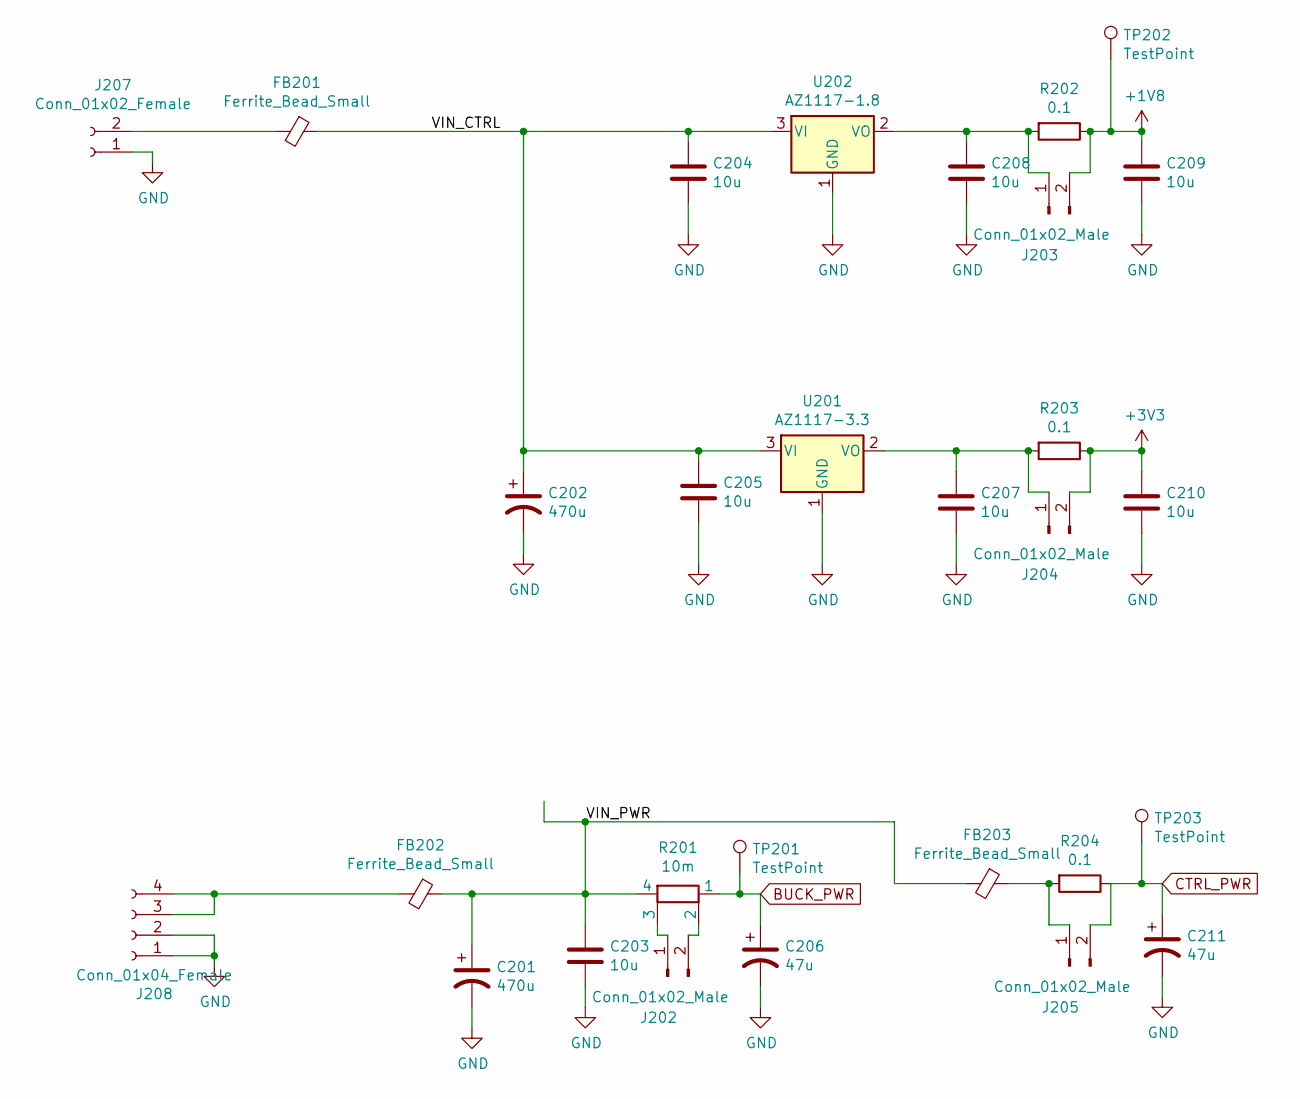
[picture p16: schematic Power.sch]

Parts:
C201, C202: 470u; CP_Elec_10x14.3; MPN MAL215375471E3
C203, C204, C205, C207, C208, C209, C210: 10u; C_0805_2012Metric
C206, C211: 47u; CP_EIA-3528-12_Kemet-T; MPN T520B476M008ATE035
FB201, FB202, FB203: Ferrite_Bead_Small; L_0805_2012Metric
J202, J203, J204, J205: Conn_01x02_Male; PinHeader_1x02_P2.54mm_Vertical
J207: Conn_01x02_Female; Terminal-block-plug_2x1_3.5mm-pitch
J208: Conn_01x04_Female; Terminal-block-plug_4x1_3.5mm-pitch; MPN 0395021004
R201: 10m; R_Shunt_Ohmite_LVK12; MPN LVK12R010CER
R202, R203, R204: 0.1; R_0603_1608Metric
TP201, TP202, TP203: TestPoint; THM_COMPACT
U201: AZ1117-3.3; SOT-223-3_TabPin2
U202: AZ1117-1.8; SOT-223-3_TabPin2

Connections:
+1V8: C209.1, J203.2, R202.1, TP202.1; also elsewhere on the board
+3V3: C210.1, J204.2, R203.1; also elsewhere on the board
/Power/VIN_CTRL: C202.1, C204.1, C205.1, FB201.1, U201.3 (VI), U202.3 (VI)
/Power/VIN_PWR: C201.1, C203.1, FB202.1, FB203.2, R201.4
BUCK_PWR: C206.1, R201.1, TP201.1; also elsewhere on the board
CTRL_PWR: C211.1, J205.2, R204.1, TP203.1; also elsewhere on the board
GND: C201.2, C202.2, C203.2, C204.2, C205.2, C206.2, C207.2, C208.2, C209.2, C210.2, C211.2, J207.1, J208.1, J208.2, U201.1 (GND), U202.1 (GND); also elsewhere on the board
unnamed: C207.1, J204.1, R203.2, U201.2 (VO)
unnamed: C208.1, J203.1, R202.2, U202.2 (VO)
unnamed: FB201.2, J207.2
unnamed: FB202.2, J208.3, J208.4
unnamed: FB203.1, J205.1, R204.2
unnamed: J202.1, R201.3
unnamed: J202.2, R201.2

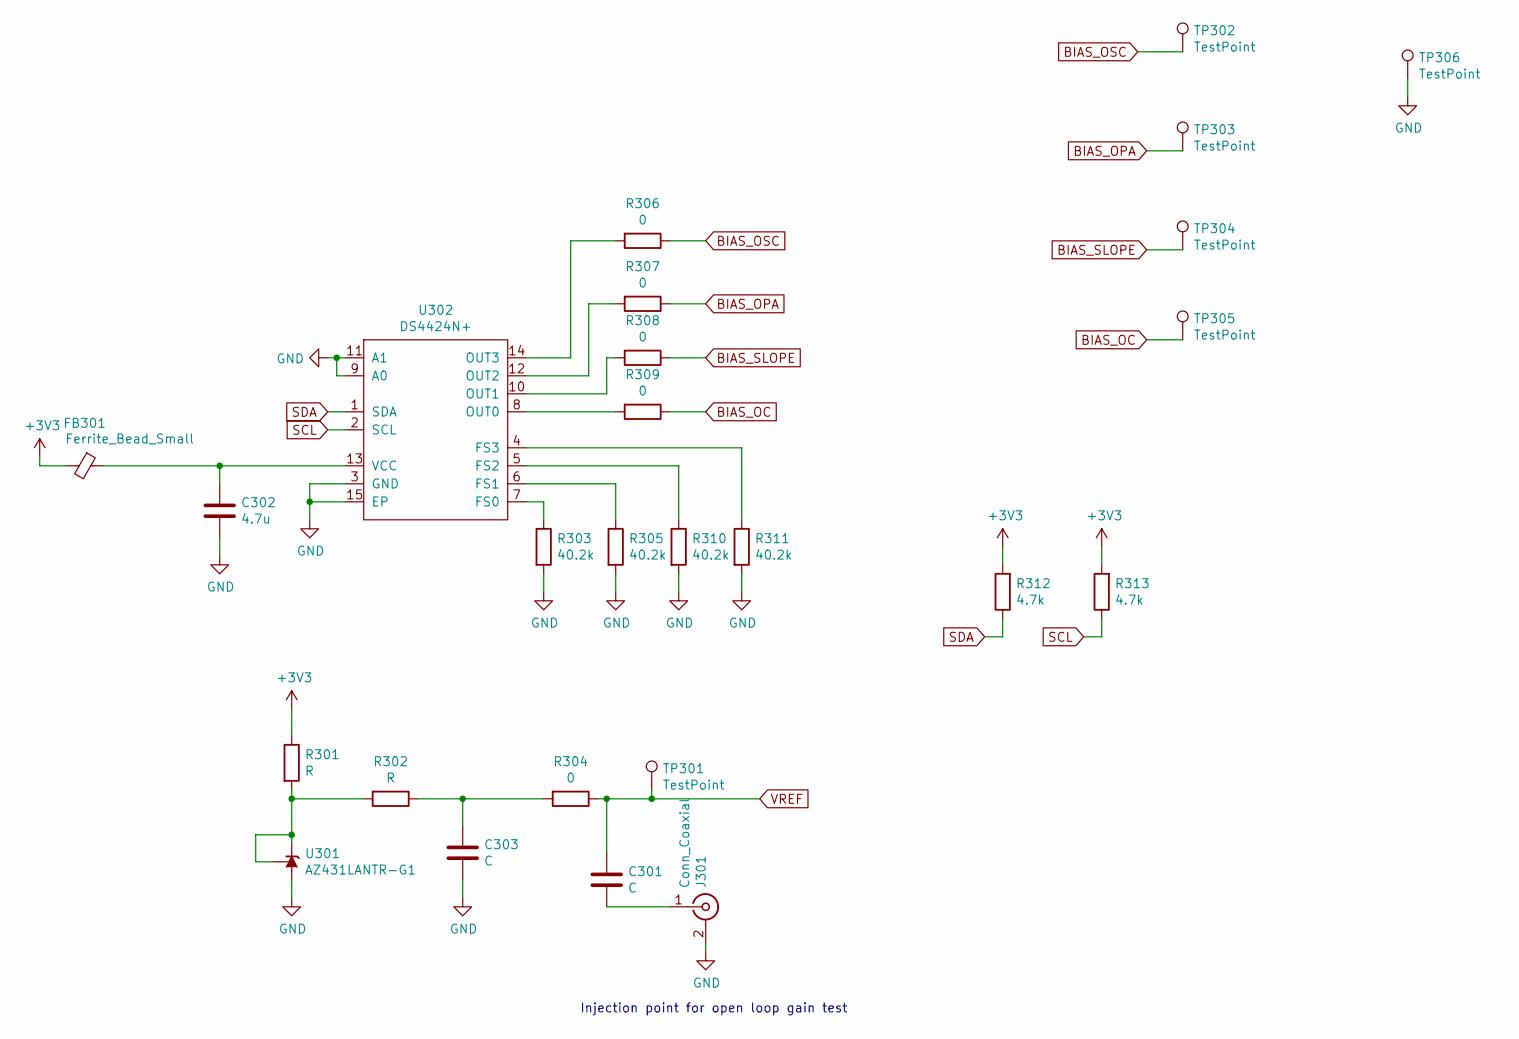
[picture p17: schematic Bias.sch]

Parts:
C301, C303: C; C_0603_1608Metric
C302: 4.7u; C_0603_1608Metric
FB301: Ferrite_Bead_Small; L_0805_2012Metric
J301: Conn_Coaxial; SMA_Amphenol_132134_Vertical
R301, R302: R; R_0603_1608Metric
R303, R305, R310, R311: 40.2k; R_0603_1608Metric
R304, R306, R307, R308, R309: 0; R_0603_1608Metric
R312, R313: 4.7k; R_0603_1608Metric
TP301, TP302, TP303, TP304, TP305, TP306: TestPoint; THM_COMPACT
U301: AZ431LANTR-G1; SOT-23; MPN AZ431LANTR-G1
U302: DS4424N+; TDFN-14-1EP_3x3mm_P0.4mm_EP1.78x2.35mm

Connections:
+3V3: FB301.2, R301.1, R312.2, R313.2; also elsewhere on the board
BIAS_OC: R309.1, TP305.1; also elsewhere on the board
BIAS_OPA: R307.1, TP303.1; also elsewhere on the board
BIAS_OSC: R306.1, TP302.1; also elsewhere on the board
BIAS_SLOPE: R308.1, TP304.1; also elsewhere on the board
GND: C302.2, C303.2, J301.2 (Ext), R303.2, R305.2, R310.2, R311.2, TP306.1, U301.3 (A), U302.3 (GND), U302.9 (A0), U302.11 (A1), U302.15 (EP); also elsewhere on the board
unnamed: C301.2, J301.1 (In)
unnamed: C302.1, FB301.1, U302.13 (VCC)
unnamed: C303.1, R302.1, R304.2
unnamed: R301.2, R302.2, U301.1 (REF), U301.2 (K)
unnamed: R303.1, U302.7 (FS0)
unnamed: R305.1, U302.6 (FS1)
unnamed: R306.2, U302.14 (OUT3)
unnamed: R307.2, U302.12 (OUT2)
unnamed: R308.2, U302.10 (OUT1)
unnamed: R309.2, U302.8 (OUT0)
unnamed: R310.1, U302.5 (FS2)
unnamed: R311.1, U302.4 (FS3)
SCL: R313.1, U302.2 (SCL); also elsewhere on the board
SDA: R312.1, U302.1 (SDA); also elsewhere on the board
VREF: C301.1, R304.1, TP301.1; also elsewhere on the board

Notes on the sheet:
Injection point for open loop gain test

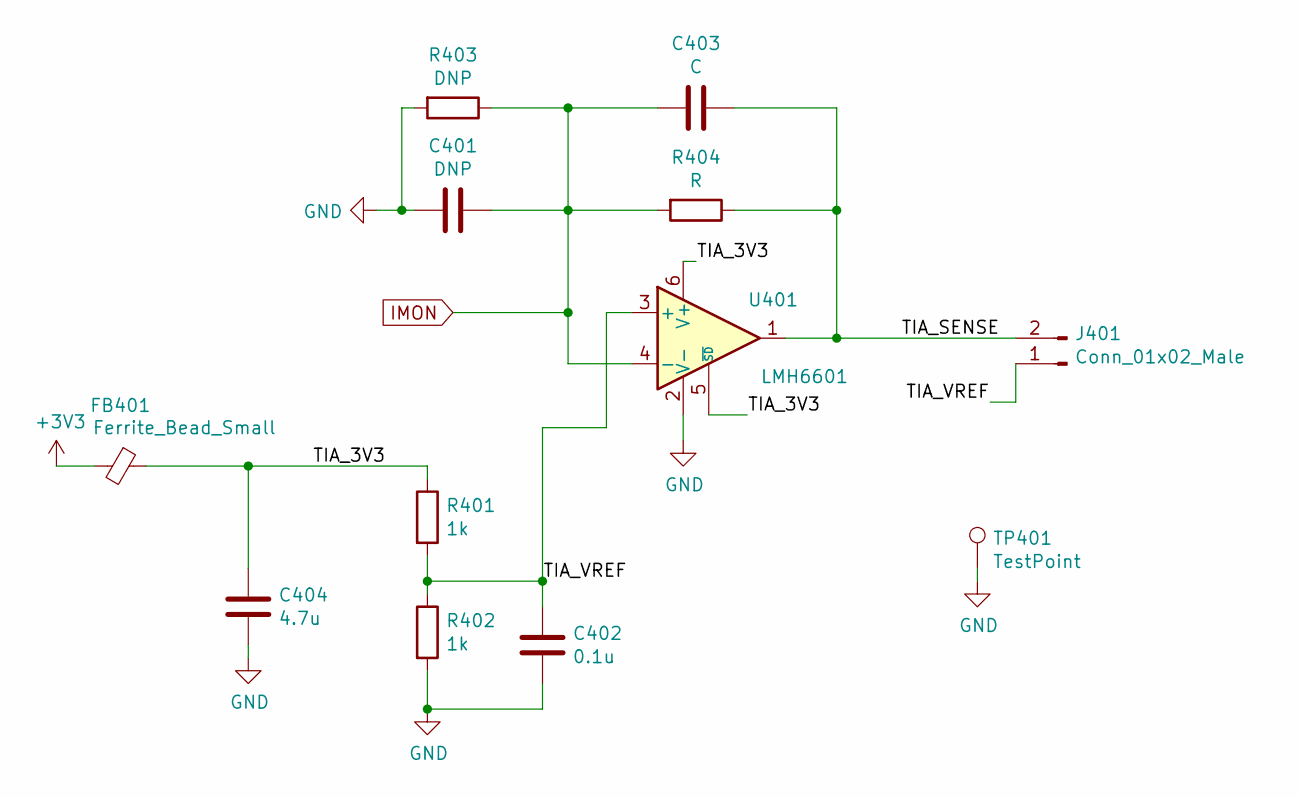
[picture p18: schematic TIA.sch]

Parts:
C401: DNP; C_0603_1608Metric
C402: 0.1u; C_0603_1608Metric
C403: C; C_0603_1608Metric
C404: 4.7u; C_0603_1608Metric
FB401: Ferrite_Bead_Small; L_0805_2012Metric
J401: Conn_01x02_Male; PinHeader_1x02_P2.54mm_Vertical
R401, R402: 1k; R_0603_1608Metric
R403: DNP; R_0603_1608Metric
R404: R; R_0603_1608Metric
TP401: TestPoint; THM_COMPACT
U401: LMH6601; TSOT-23-6

Connections:
+3V3: FB401.2; also elsewhere on the board
/TIA/TIA_3V3: C404.1, FB401.1, R401.1, U401.5 (~SD), U401.6 (V+)
/TIA/TIA_SENSE: C403.1, J401.2, R404.1, U401.1
/TIA/TIA_VREF: C402.1, J401.1, R401.2, R402.1, U401.3 (+)
GND: C401.2, C402.2, C404.2, R402.2, R403.2, TP401.1, U401.2 (V-); also elsewhere on the board
IMON: C401.1, C403.2, R403.1, R404.2, U401.4 (-); also elsewhere on the board

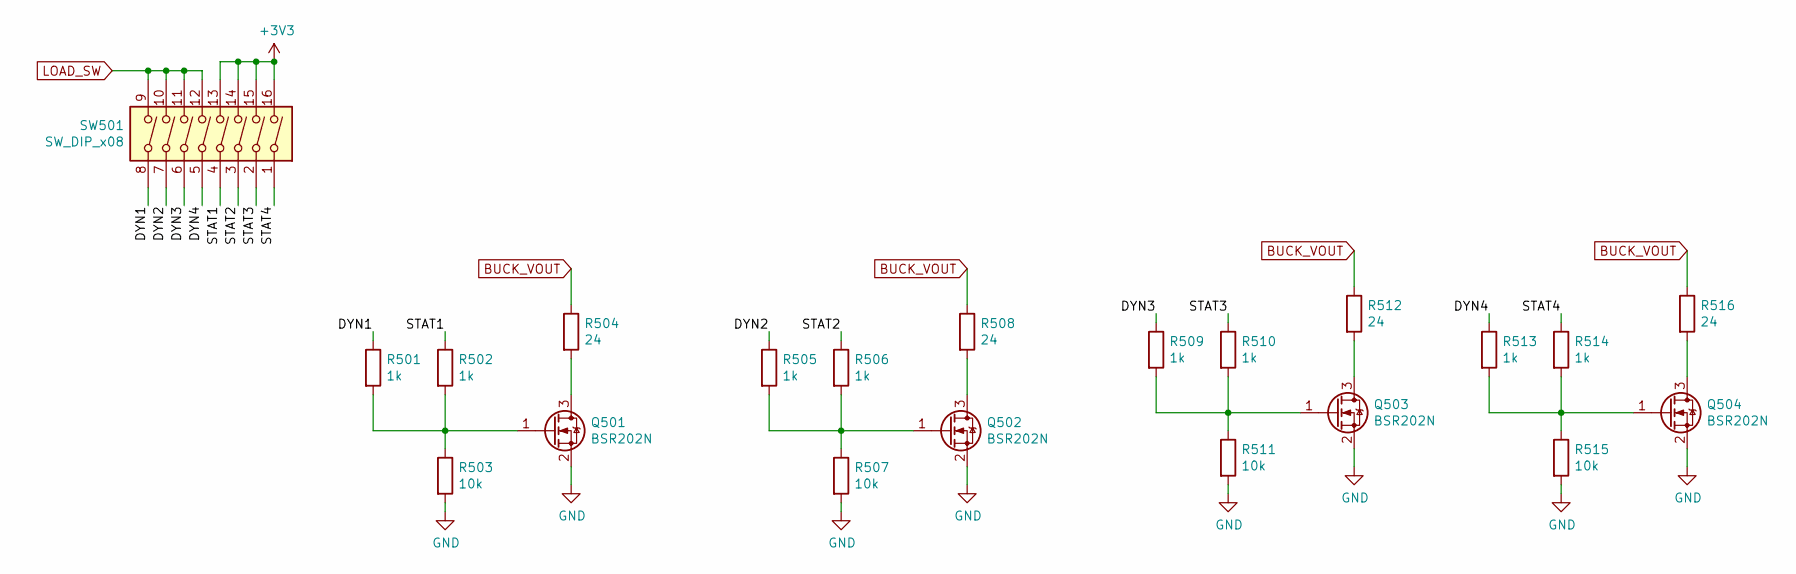
[picture p19: schematic Load.sch]

Parts:
Q501, Q502, Q503, Q504: BSR202N; SOT-23; MPN BSR202NL6327HTSA1
R501, R502, R505, R506, R509, R510, R513, R514: 1k; R_0603_1608Metric
R503, R507, R511, R515: 10k; R_0603_1608Metric
R504, R508, R512, R516: 24; R_2512_6332Metric
SW501: SW_DIP_x08; SW_DIP_SPSTx08_Slide_6.7x21.88mm_W7.62mm_P2.54mm_LowProfile; MPN DS01C-254-S-08BE

Connections:
+3V3: SW501.13, SW501.14, SW501.15, SW501.16; also elsewhere on the board
/Load/DYN1: R501.1, SW501.8
/Load/DYN2: R505.1, SW501.7
/Load/DYN3: R509.1, SW501.6
/Load/DYN4: R513.1, SW501.5
/Load/STAT1: R502.1, SW501.4
/Load/STAT2: R506.1, SW501.3
/Load/STAT3: R510.1, SW501.2
/Load/STAT4: R514.1, SW501.1
BUCK_VOUT: R504.1, R508.1, R512.1, R516.1
GND: Q501.2 (S), Q502.2 (S), Q503.2 (S), Q504.2 (S), R503.2, R507.2, R511.2, R515.2; also elsewhere on the board
LOAD_SW: SW501.9, SW501.10, SW501.11, SW501.12; also elsewhere on the board
unnamed: Q501.1 (G), R501.2, R502.2, R503.1
unnamed: Q501.3 (D), R504.2
unnamed: Q502.1 (G), R505.2, R506.2, R507.1
unnamed: Q502.3 (D), R508.2
unnamed: Q503.1 (G), R509.2, R510.2, R511.1
unnamed: Q503.3 (D), R512.2
unnamed: Q504.1 (G), R513.2, R514.2, R515.1
unnamed: Q504.3 (D), R516.2

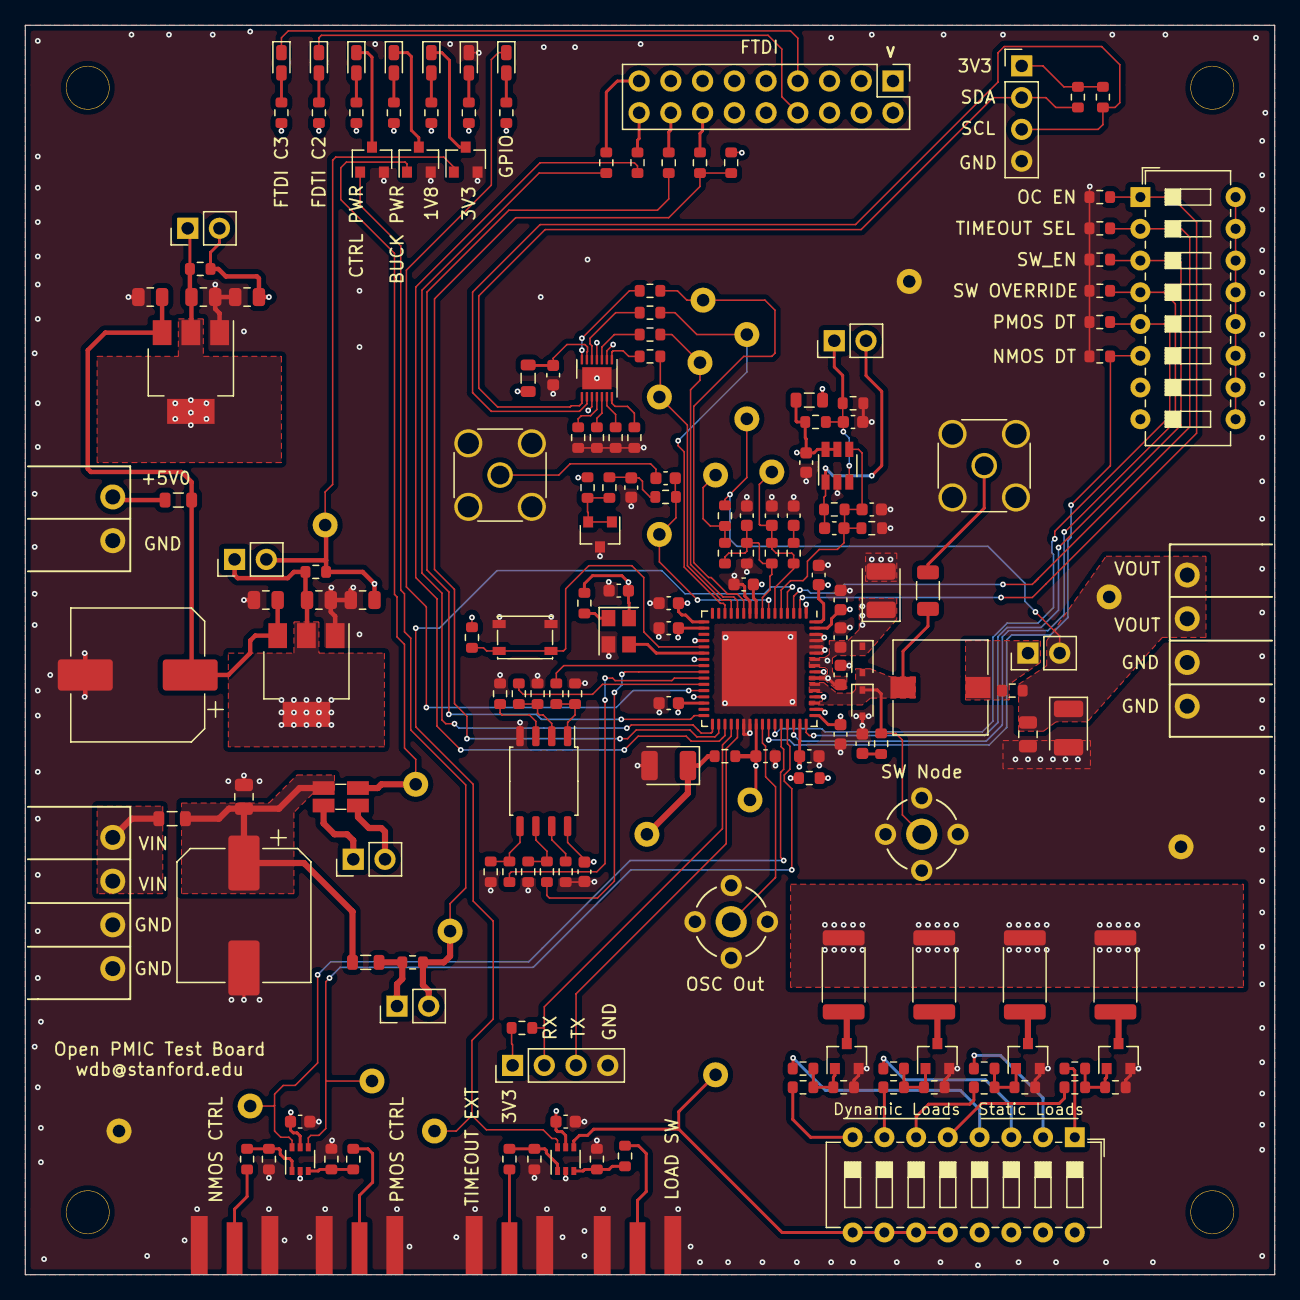
[picture p20: board pmic-test-board.kicad_pcb from above]

Board: 4 copper layers, 100.0 x 100.0 mm, 205 parts (0 on the bottom side), 120 nets.
