westonb/open-pmic-pcb/(commit log)

2021-11-18 initial schematic capture
    [Bias.sch, Load.sch, Power.sch, TIA.sch, pmic-test-board.kicad_pcb, pmic-test-board.sch]
2021-12-02 more schematic capture
    [Bias.sch, Load.sch, Power.sch, TIA.sch, pmic-test-board.sch]
2021-12-14 PCB routing done
    [Bias.sch, Load.sch, Power.sch, TIA.sch, pmic-test-board.sch]
2021-12-18 schematic review and gerber generation
    [TIA.sch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]
2022-02-09 added test firmware and test results
    [Bias.sch, Load.sch, Power.sch, TIA.sch, eff_test1.csv, pmic-test-board.csv, pmic-test-board.sch]
